Guimli/Pico2-MSX/hardware/Images/Pico2-MSX-front.jpg

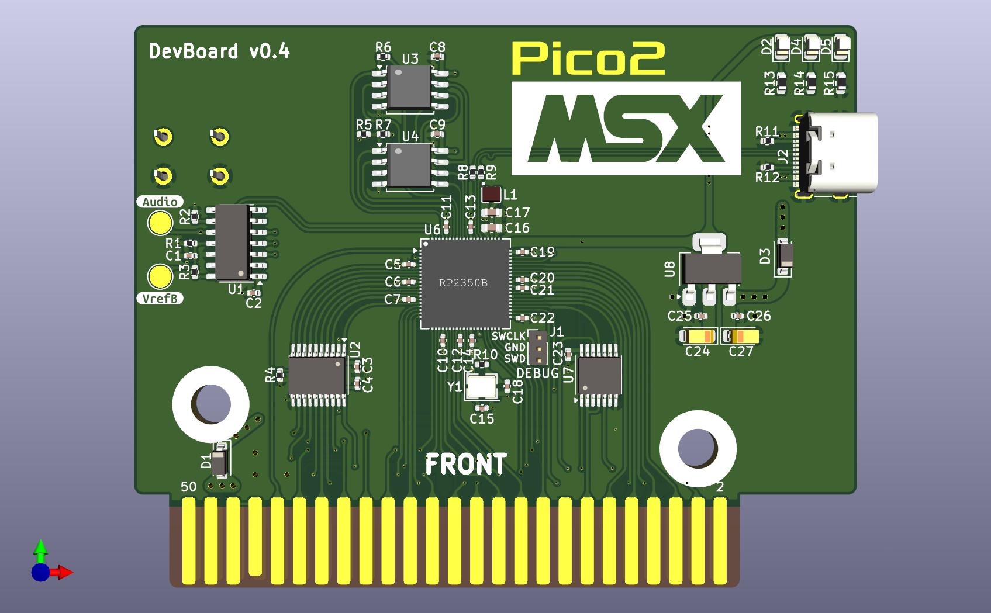
hardware/Images/Pico2-MSX-front.jpg
