Guimli/Pico2-MSX/hardware/Images/Pico2-MSX-back.jpg

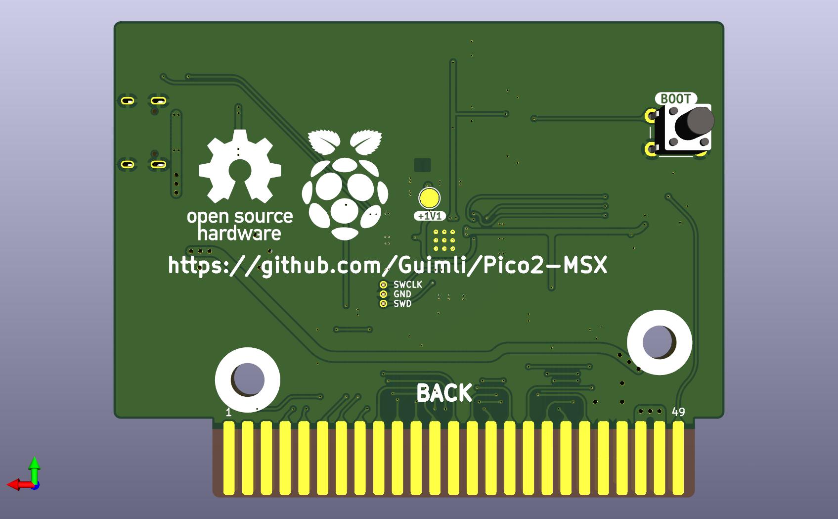
hardware/Images/Pico2-MSX-back.jpg
