Guimli/Pico2-MSX/hardware/3D/L_0806_2016.step

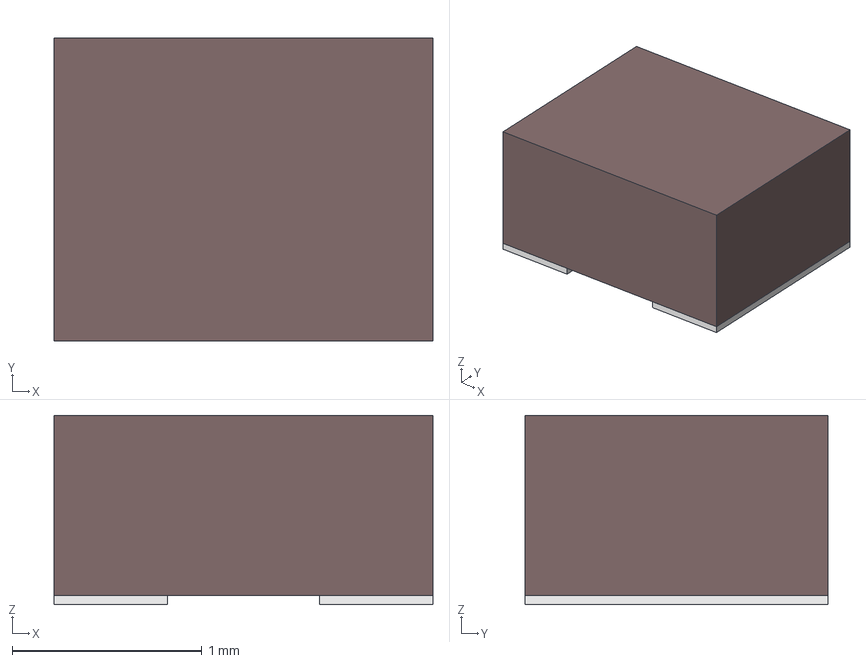
[picture p3: CAD file, 2024-10-25]
hardware/3D/L_0806_2016.step
2.00 x 1.60 x 1.00 mm
Boîte
Boîte001
