Guimli/Pico2-MSX/hardware/3D/SOIC8.STEP

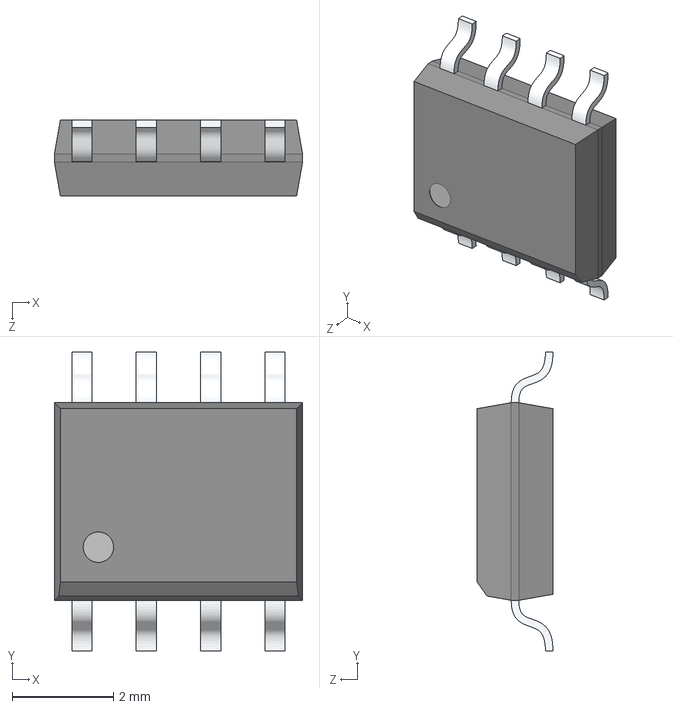
[picture p4: CAD file, 2024-09-10]
hardware/3D/SOIC8.STEP
4.90 x 5.90 x 1.50 mm
