Guimli/Pico2-MSX/hardware/3D/RP2350_QFN80.step

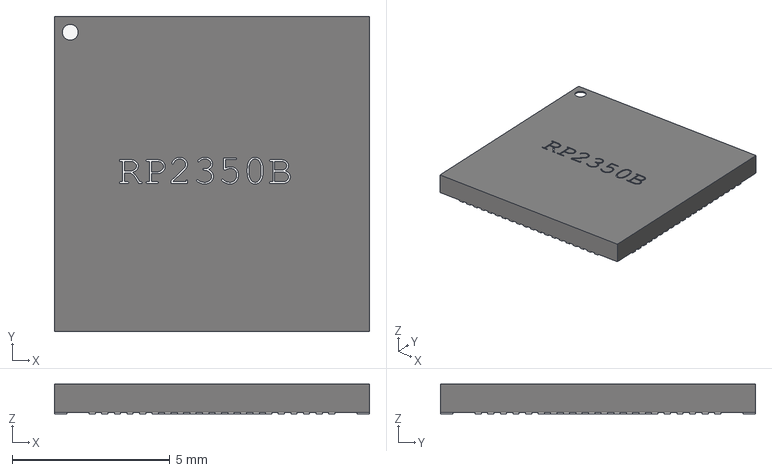
[picture p5: CAD file, 2024-09-10]
hardware/3D/RP2350_QFN80.step
10.0 x 10.0 x 0.95 mm
