Guimli/Pico2-MSX/hardware/Pico2-MSX.pdf

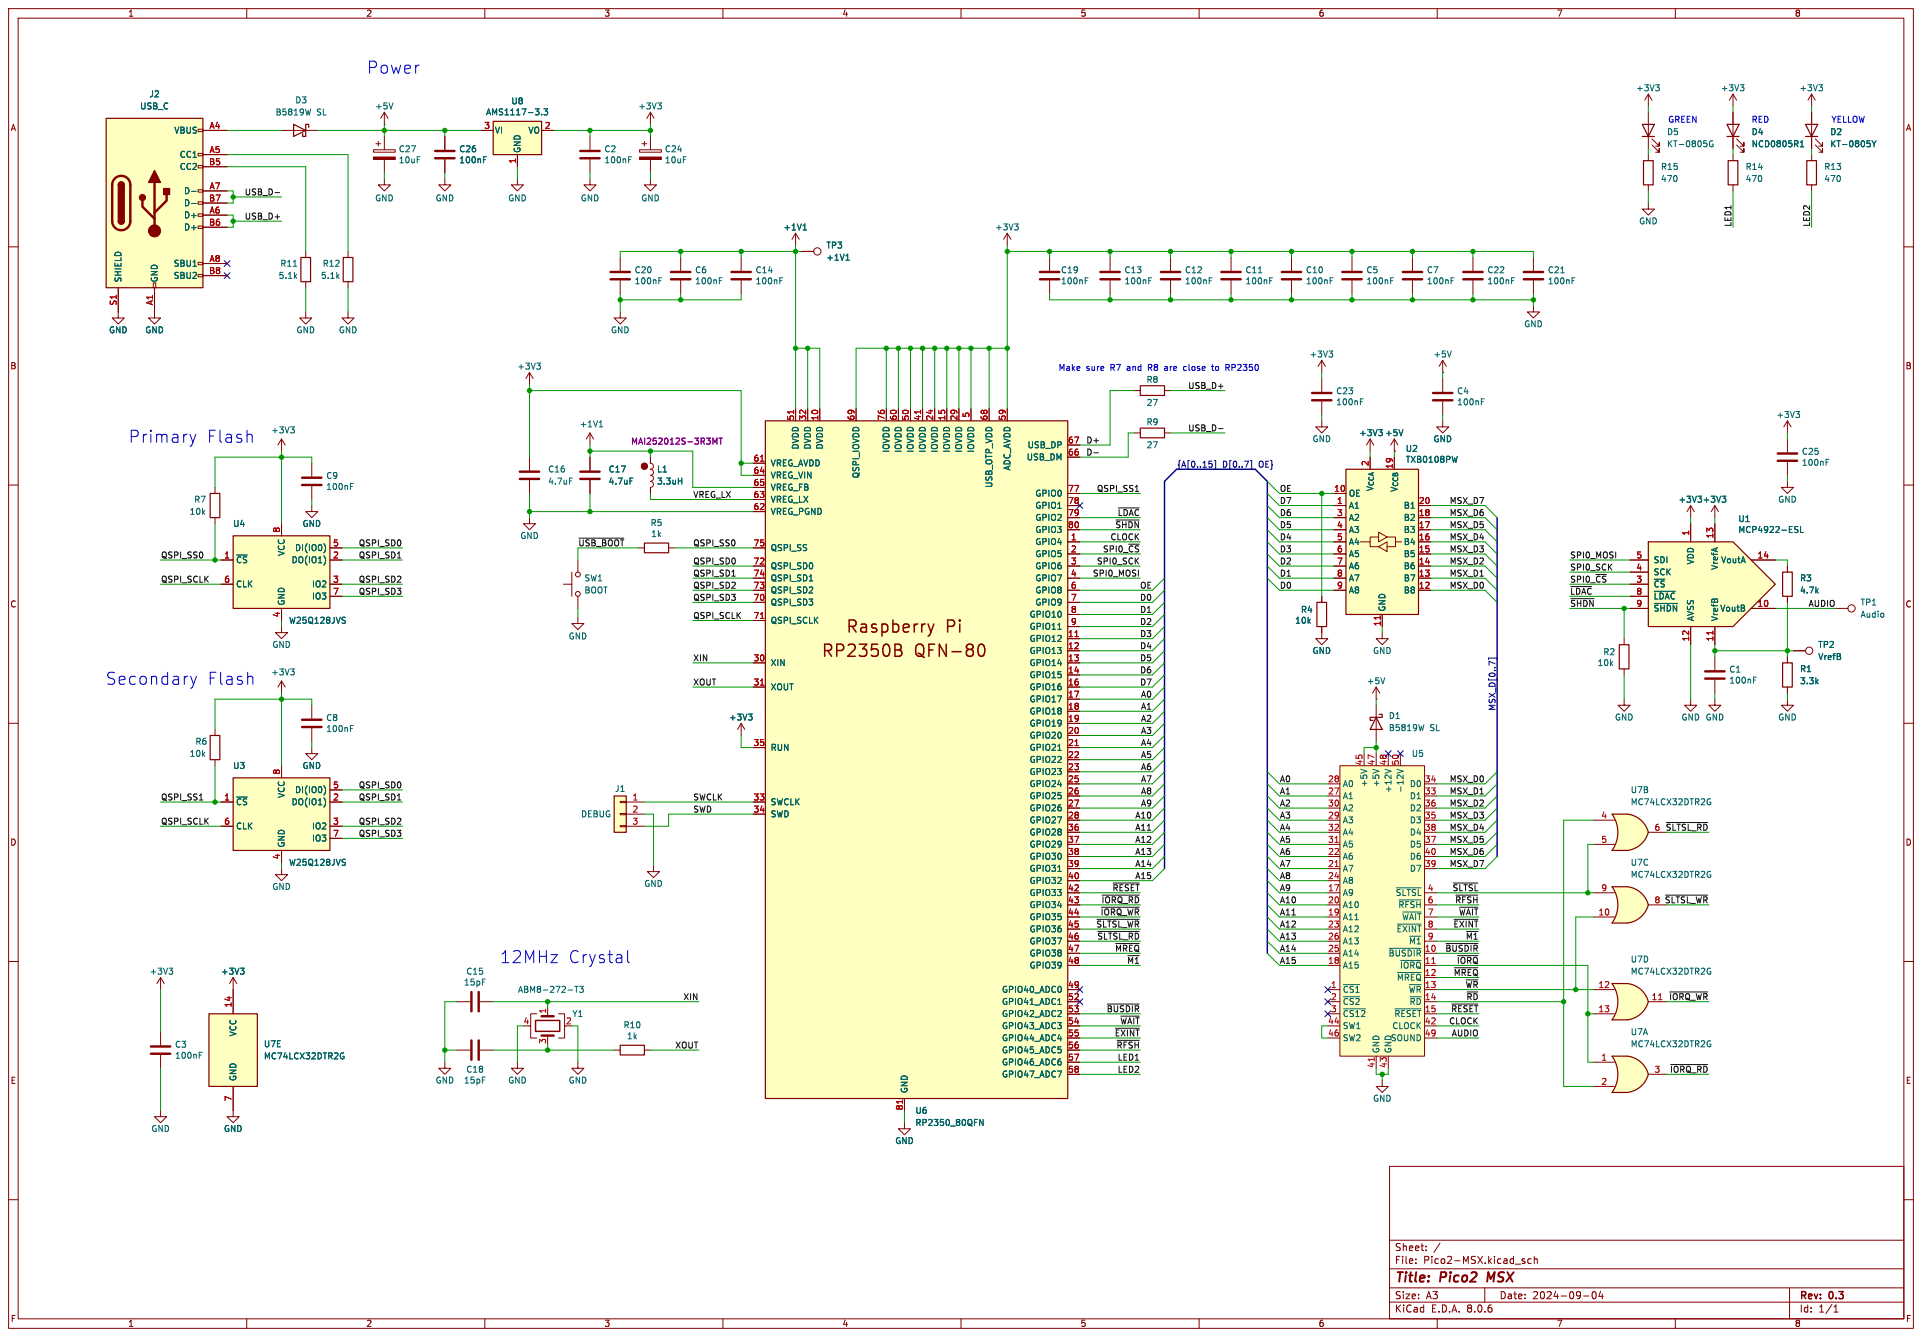
[picture p6: page 1]

1 VO 2 VI 3 U8 AMS1117-3.3 ~{CS} 1 DO(IO1) 2

5 IOVDD 50 DVDD 51 GPIO41_ADC1 52 GPIO42_ADC2 53 GPIO43_ADC3 54 GPIO44_ADC4 55 GPIO45_ADC5 56 GPIO46_ADC6 57 GPIO47_ADC7 58 ADC_AVDD 59 GPIO8 6 IOVDD 60 VREG_AVDD 61 VREG_PGND 62 VREG_LX 63 VREG_VIN 64 VREG_FB 65 USB_DM 66 USB_DP 67 USB_OTP_VDD 68 QSPI_IOVDD 69 GPIO9 7 QSPI_SD3 70 QSPI_SCLK 71 QSPI_SD0 72 QSPI_SD2 73 QSPI_SD1 74 QSPI_SS 75 IOVDD 76 GPIO0 77 GPIO1 78 GPIO2 79 GPIO10 8 GPIO3 80 GND 81 GPIO11 9 +3V3 GND

5 IOVDD 50 DVDD 51 GPIO41_ADC1 52 GPIO42_ADC2 53 GPIO43_ADC3 54 GPIO44_ADC4 55 GPIO45_ADC5 56 GPIO46_ADC6 57 GPIO47_ADC7 58 ADC_AVDD 59 GPIO8 6 IOVDD 60 VREG_AVDD 61 VREG_PGND 62 VREG_LX 63 VREG_VIN 64 VREG_FB 65 USB_DM 66 USB_DP 67 USB_OTP_VDD 68 QSPI_IOVDD 69 GPIO9 7 QSPI_SD3 70 QSPI_SCLK 71 QSPI_SD0 72 QSPI_SD2 73 QSPI_SD1 74 QSPI_SS 75 IOVDD 76 GPIO0 77 GPIO1 78 GPIO2 79 GPIO10 8 GPIO3 80 GND 81 GPIO11 9 U6 RP2350_80QFN
