Guimli/Pico2-MSX/hardware/Pico2-MSX.kicad_pcb

## KiCad design hardware/Pico2-MSX.kicad_pcb (2024-11-30)

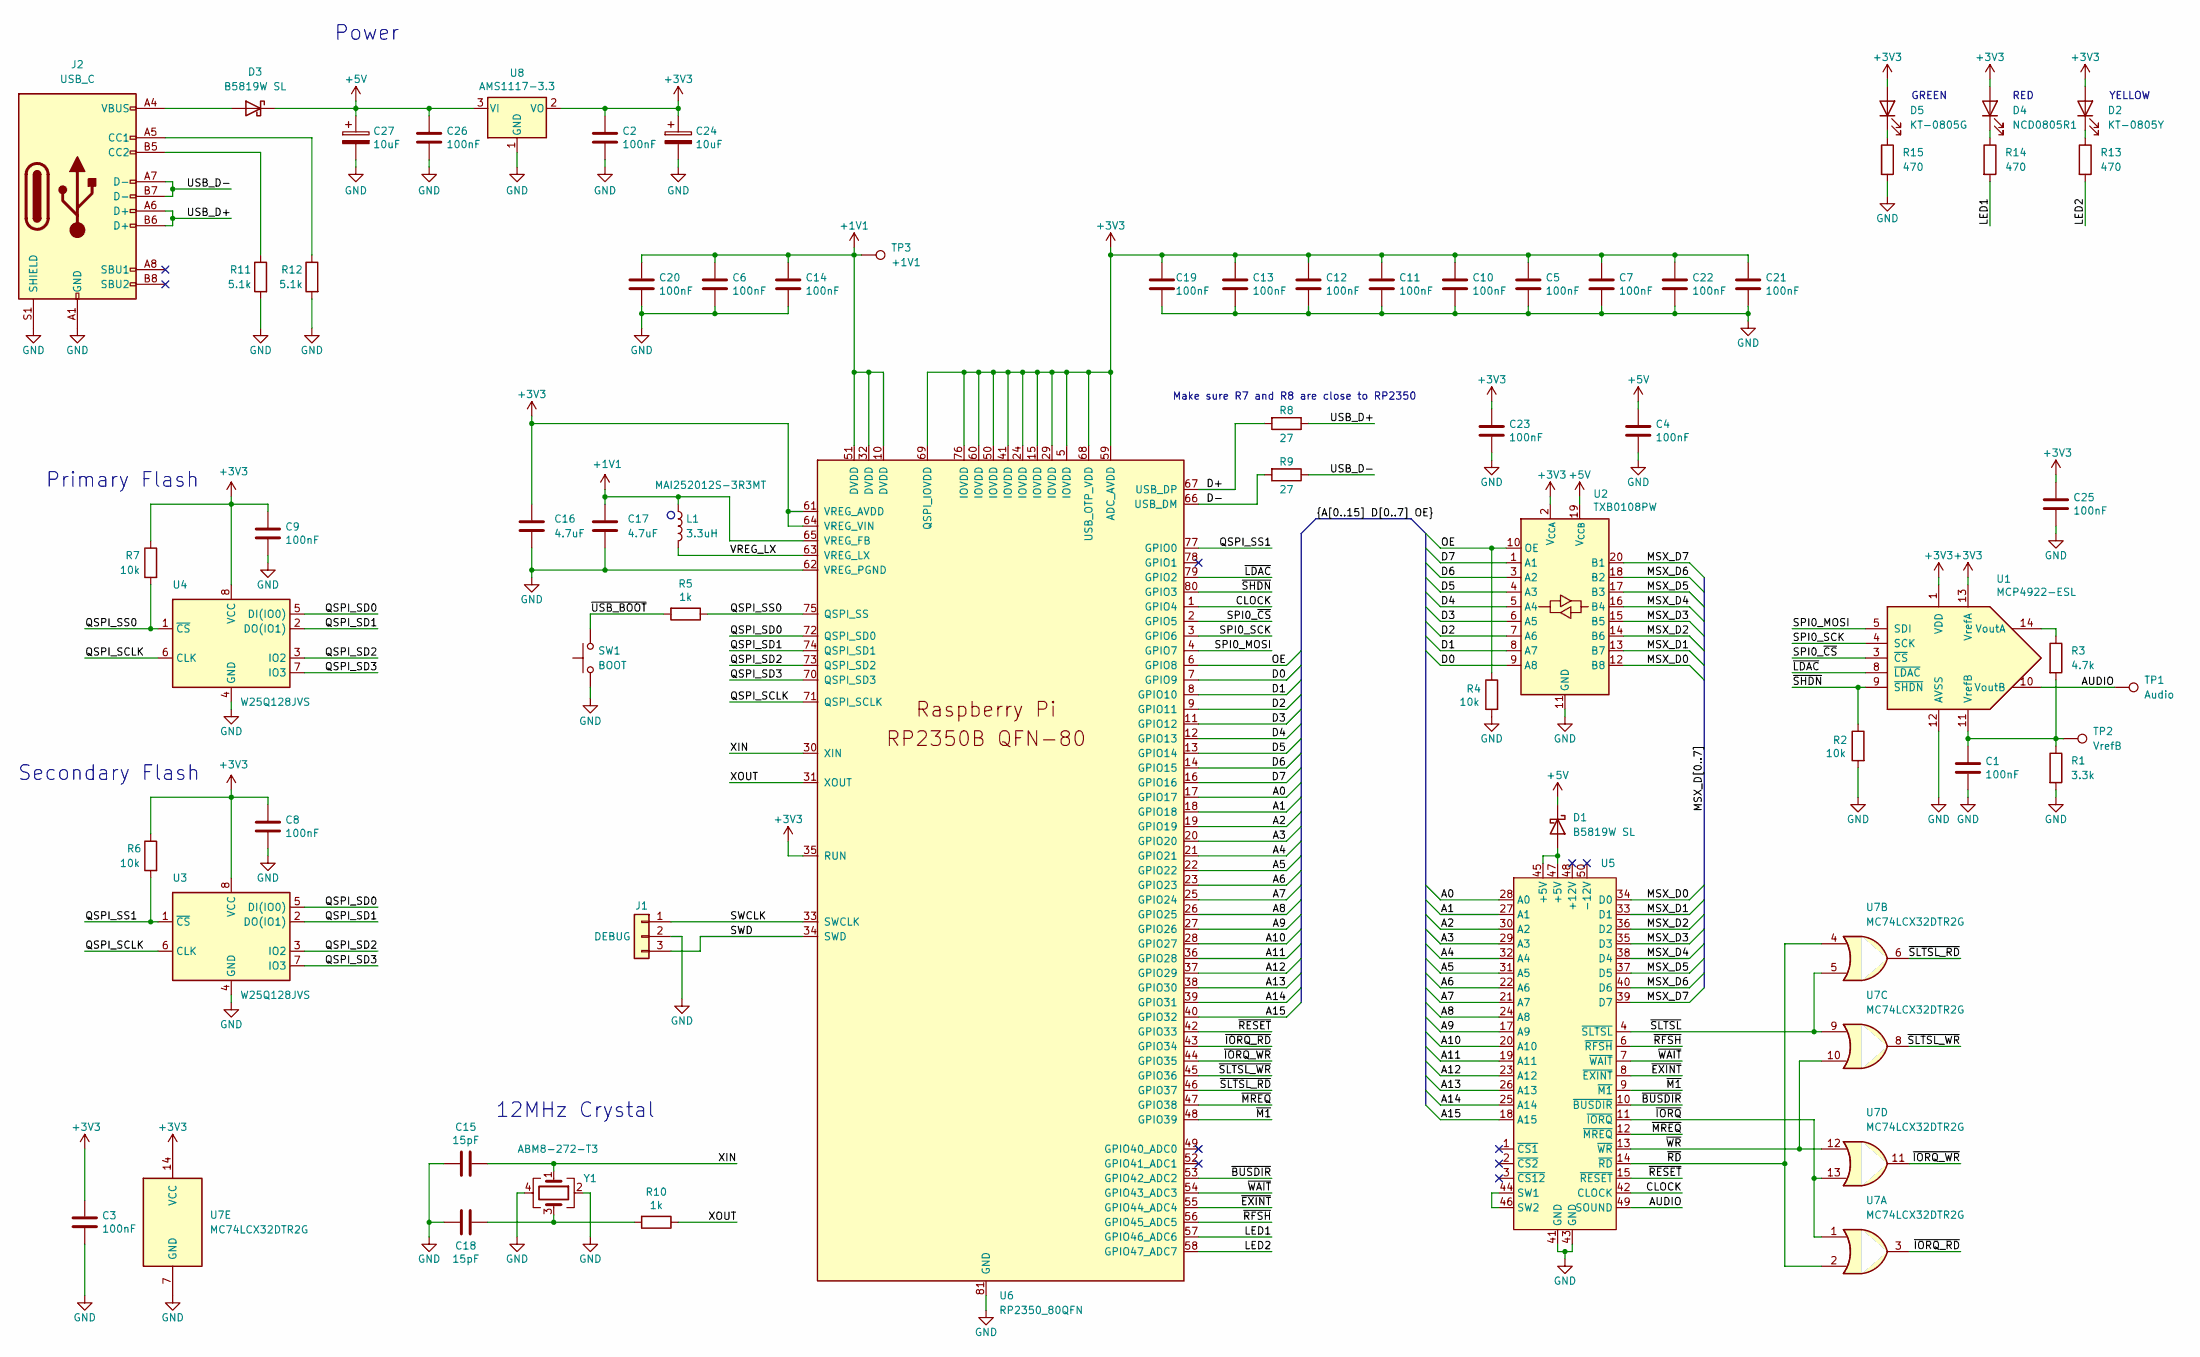
[picture p7: schematic Pico2-MSX.kicad_sch, Pico2 MSX]

Parts:
C1, C2, C3, C4, C8, C9, C23, C25, C26: 100nF; C_0402_1005Metric; LCSC C307331
C5, C6, C7, C10, C11, C12, C13, C14, C19, C20, C21, C22: 100nF; C_0402_1005Metric_thin; LCSC C307331
C15, C18: 15pF; C_0402_1005Metric; LCSC C1548
C16, C17: 4.7uF; C_0603_1608Metric_small; LCSC C19666
C24, C27: 10uF; CP_EIA-3216-18_Kemet-A; LCSC C7171
D1, D3: B5819W SL; D_SOD-123; LCSC C8598
D2: KT-0805Y; LED_0805_2012Metric; LCSC C2296
D4: NCD0805R1; LED_0805_2012Metric; LCSC C84256
D5: KT-0805G; LED_0805_2012Metric; LCSC C2297
J1: DEBUG; PinHeader_1x03_P1.27mm_Vertical; LCSC C24980
J2: USB_C; USB_C_Receptacle_G-Switch_GT-USB-7010ASV; LCSC C2988369
L1: 3.3uH; L_pol_2016; LCSC C520252
R1: 3.3k; R_0402_1005Metric; LCSC C25890
R2, R4, R6, R7: 10k; R_0402_1005Metric; LCSC C25744
R3: 4.7k; R_0402_1005Metric; LCSC C25900
R5, R10: 1k; R_0402_1005Metric; LCSC C11702
R8, R9: 27; R_0402_1005Metric; LCSC C25100
R11, R12: 5.1k; R_0402_1005Metric; LCSC C25905
R13, R14, R15: 470; R_0603_1608Metric; LCSC C23179
SW1: BOOT; SW_PUSH_6mm_H7.3mm
TP1: Audio; TestPoint_Pad_D2.5mm
TP2: VrefB; TestPoint_Pad_D2.5mm
TP3: +1V1; TestPoint_Pad_D2.5mm
U1: MCP4922-ESL; SOIC-14_3.9x8.7mm_P1.27mm; LCSC C39851
U2: TXB0108PW; TSSOP-20_4.4x6.5mm_P0.65mm; LCSC C53406
U3, U4: W25Q128JVS; SOIC-8_5.23x5.23mm_P1.27mm; LCSC C97521
U5: MSX_Cartridge
U6: RP2350_80QFN; RP2350-QFN-80-1EP_10x10_P0.4mm_EP3.4x3.4mm_ThermalVias; LCSC C9900138392
U7: MC74LCX32DTR2G; TSSOP-14_4.4x5mm_P0.65mm; LCSC C904104
U8: AMS1117-3.3; SOT-223-3_TabPin2; LCSC C6186
Y1: ABM8-272-T3; Crystal_SMD_3225-4Pin_3.2x2.5mm; LCSC C9002

Connections:
+1V1: C6.1, C14.1, C17.1, C20.1, L1.1, TP3.1, U6.10 (DVDD), U6.32 (DVDD), U6.51 (DVDD), U6.65 (VREG_FB)
+3V3: C2.1, C3.1, C5.1, C7.1, C8.1, C9.1, C10.1, C11.1, C12.1, C13.1, C16.1, C19.1, C21.1, C22.1, C23.1, C24.1, C25.1, D2.2 (A), D4.2 (A), D5.2 (A), R6.1, R7.1, U1.1 (VDD), U1.13 (VrefA), U2.2 (V_{CCA}), U3.8 (VCC), U4.8 (VCC), U6.5 (IOVDD), U6.15 (IOVDD), U6.24 (IOVDD), U6.29 (IOVDD), U6.35 (RUN), U6.41 (IOVDD), U6.50 (IOVDD), U6.59 (ADC_AVDD), U6.60 (IOVDD), U6.61 (VREG_AVDD), U6.64 (VREG_VIN), U6.68 (USB_OTP_VDD), U6.69 (QSPI_IOVDD), U6.76 (IOVDD), U7.14 (VCC), U8.2 (VO)
+5V: C4.1, C26.1, C27.1, D1.1 (K), D3.1 (K), U2.19 (V_{CCB}), U8.3 (VI)
/A0: U5.28 (A0), U6.17 (GPIO17)
/A1: U5.27 (A1), U6.18 (GPIO18)
/A2: U5.30 (A2), U6.19 (GPIO19)
/A3: U5.29 (A3), U6.20 (GPIO20)
/A4: U5.32 (A4), U6.21 (GPIO21)
/A5: U5.31 (A5), U6.22 (GPIO22)
/A6: U5.22 (A6), U6.23 (GPIO23)
/A7: U5.21 (A7), U6.25 (GPIO24)
/A8: U5.24 (A8), U6.26 (GPIO25)
/A9: U5.17 (A9), U6.27 (GPIO26)
/A10: U5.20 (A10), U6.28 (GPIO27)
/A11: U5.19 (A11), U6.36 (GPIO28)
/A12: U5.23 (A12), U6.37 (GPIO29)
/A13: U5.26 (A13), U6.38 (GPIO30)
/A14: U5.25 (A14), U6.39 (GPIO31)
/A15: U5.18 (A15), U6.40 (GPIO32)
/AUDIO: TP1.1, U1.10 (VoutB), U5.49 (SOUND)
/CLOCK: U5.42 (CLOCK), U6.1 (GPIO4)
/D0: U2.9 (A8), U6.7 (GPIO9)
/D1: U2.8 (A7), U6.8 (GPIO10)
/D2: U2.7 (A6), U6.9 (GPIO11)
/D3: U2.6 (A5), U6.11 (GPIO12)
/D4: U2.5 (A4), U6.12 (GPIO13)
/D5: U2.4 (A3), U6.13 (GPIO14)
/D6: U2.3 (A2), U6.14 (GPIO15)
/D7: U2.1 (A1), U6.16 (GPIO16)
/D+: R8.2, U6.67 (USB_DP)
/D-: R9.2, U6.66 (USB_DM)
/LED1: R14.2, U6.57 (GPIO46_ADC6)
/LED2: R13.2, U6.58 (GPIO47_ADC7)
/MSX_D0: U2.12 (B8), U5.34 (D0)
/MSX_D1: U2.13 (B7), U5.33 (D1)
/MSX_D2: U2.14 (B6), U5.36 (D2)
/MSX_D3: U2.15 (B5), U5.35 (D3)
/MSX_D4: U2.16 (B4), U5.38 (D4)
/MSX_D5: U2.17 (B3), U5.37 (D5)
/MSX_D6: U2.18 (B2), U5.40 (D6)
/MSX_D7: U2.20 (B1), U5.39 (D7)
/OE: R4.1, U2.10 (OE), U6.6 (GPIO8)
/QSPI_SCLK: U3.6 (CLK), U4.6 (CLK), U6.71 (QSPI_SCLK)
/QSPI_SD0: U3.5 (DI(IO0)), U4.5 (DI(IO0)), U6.72 (QSPI_SD0)
/QSPI_SD1: U3.2 (DO(IO1)), U4.2 (DO(IO1)), U6.74 (QSPI_SD1)
/QSPI_SD2: U3.3 (IO2), U4.3 (IO2), U6.73 (QSPI_SD2)
/QSPI_SD3: U3.7 (IO3), U4.7 (IO3), U6.70 (QSPI_SD3)
/QSPI_SS0: R5.1, R7.2, U4.1 (~CS), U6.75 (QSPI_SS)
/QSPI_SS1: R6.2, U3.1 (~CS), U6.77 (GPIO0)
/SPI0_MOSI: U1.5 (SDI), U6.4 (GPIO7)
/SPI0_SCK: U1.4 (SCK), U6.3 (GPIO6)
/SPI0_~CS: U1.3 (~CS), U6.2 (GPIO5)
/SWCLK: J1.1, U6.33 (SWCLK)
/SWD: J1.3, U6.34 (SWD)
/USB_D+: J2.A6 (D+), J2.B6 (D+), R8.1
/USB_D-: J2.A7 (D-), J2.B7 (D-), R9.1
/VREG_LX: L1.2, U6.63 (VREG_LX)
/XIN: C15.1, U6.30 (XIN), Y1.1
/XOUT: R10.1, U6.31 (XOUT)
/~BUSDIR: U5.10 (~BUSDIR), U6.53 (GPIO42_ADC2)
/~EXINT: U5.8 (~EXINT), U6.55 (GPIO44_ADC4)
/~IORQ_RD: U6.43 (GPIO34), U7.3
/~IORQ_WR: U6.44 (GPIO35), U7.11
/~IORQ: U5.11 (~IORQ), U7.1, U7.13
/~LDAC: U1.8 (~LDAC), U6.79 (GPIO2)
/~M1: U5.9 (~M1), U6.48 (GPIO39)
/~MREQ: U5.12 (~MREQ), U6.47 (GPIO38)
/~RD: U5.14 (~RD), U7.2, U7.4
/~RESET: U5.15 (~RESET), U6.42 (GPIO33)
/~RFSH: U5.6 (~RFSH), U6.56 (GPIO45_ADC5)
/~SHDN: R2.1, U1.9 (~SHDN), U6.80 (GPIO3)
/~SLTSL_RD: U6.46 (GPIO37), U7.6
/~SLTSL_WR: U6.45 (GPIO36), U7.8
/~SLTSL: U5.4 (~SLTSL), U7.5, U7.9
/~USB_BOOT: R5.2, SW1.2
/~WAIT: U5.7 (~WAIT), U6.54 (GPIO43_ADC3)
/~WR: U5.13 (~WR), U7.10, U7.12
GND: C1.2, C2.2, C3.2, C4.2, C5.2, C6.2, C7.2, C8.2, C9.2, C10.2, C11.2, C12.2, C13.2, C14.2, C15.2, C16.2, C17.2, C18.2, C19.2, C20.2, C21.2, C22.2, C23.2, C24.2, C25.2, C26.2, C27.2, J1.2, J2.A1 (GND), J2.A12 (GND), J2.B1 (GND), J2.B12 (GND), J2.S1 (SHIELD), R1.2, R2.2, R4.2, R11.2, R12.2, R15.2, SW1.1, U1.12 (AVSS), U2.11 (GND), U3.4 (GND), U4.4 (GND), U5.41 (GND), U5.43 (GND), U6.62 (VREG_PGND), U6.81 (GND), U7.7 (GND), U8.1 (GND), Y1.2, Y1.4
unnamed: C18.1, R10.2, Y1.3
unnamed: D1.2 (A), U5.45 (+5V), U5.47 (+5V)
unnamed: D2.1 (K), R13.1
unnamed: D3.2 (A), J2.A4 (VBUS), J2.A9 (VBUS), J2.B4 (VBUS), J2.B9 (VBUS)
unnamed: D4.1 (K), R14.1
unnamed: D5.1 (K), R15.1
unnamed: J2.A5 (CC1), R12.1
unnamed: J2.B5 (CC2), R11.1
unnamed: R3.1, U1.14 (VoutA)
unnamed: C1.1, R1.1, R3.2, TP2.1, U1.11 (VrefB)
unnamed: U5.44 (SW1), U5.46 (SW2)

Notes on the sheet:
12MHz Crystal
RED
Primary Flash
YELLOW
Make sure R7 and R8 are close to RP2350
Secondary Flash
Power
GREEN

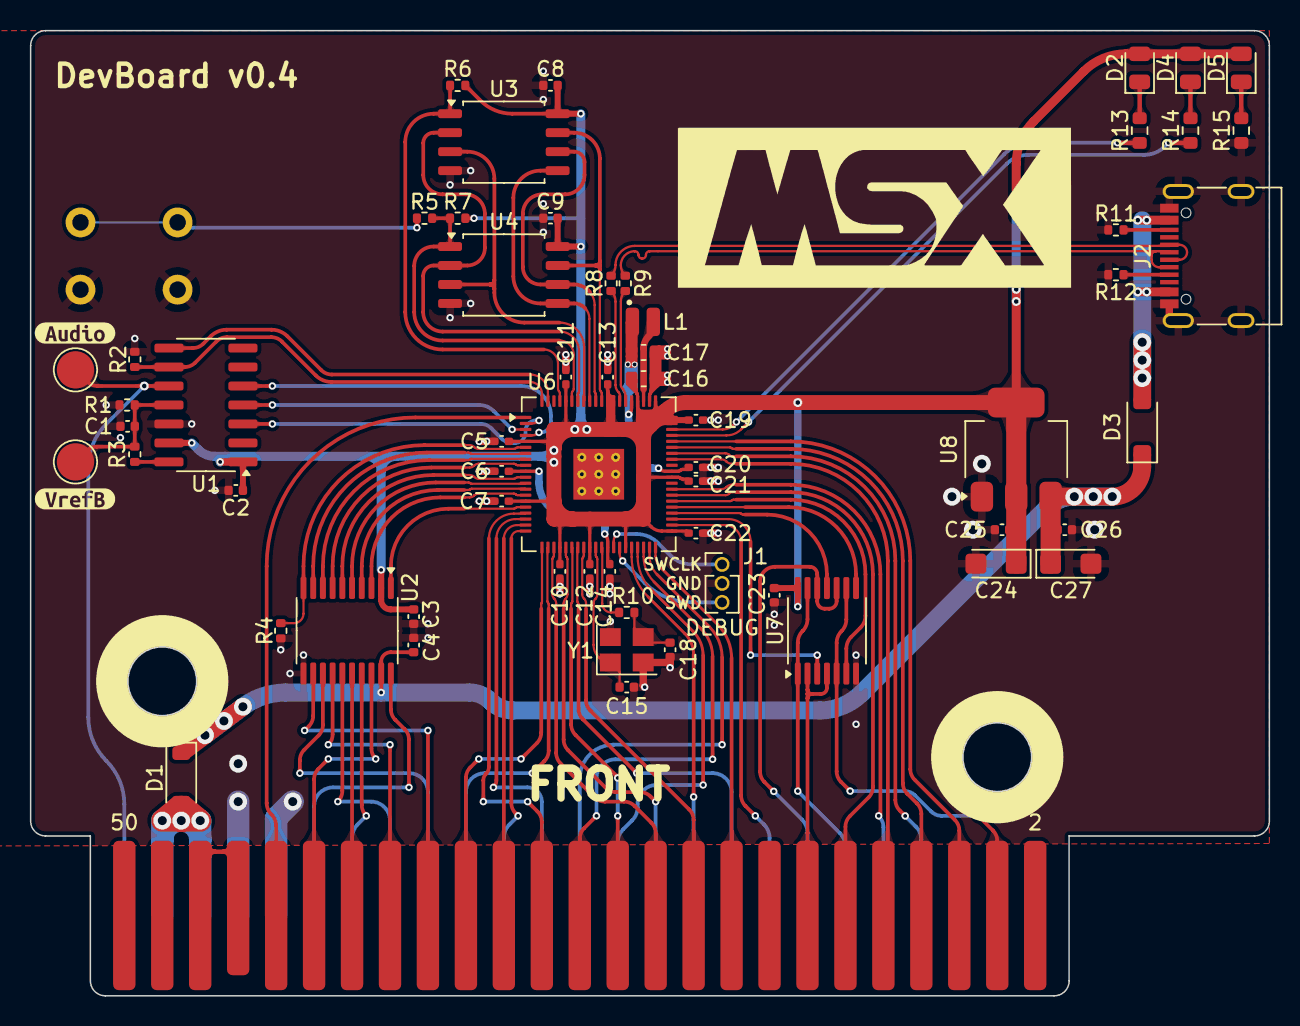
[picture p8: board Pico2-MSX.kicad_pcb from above]

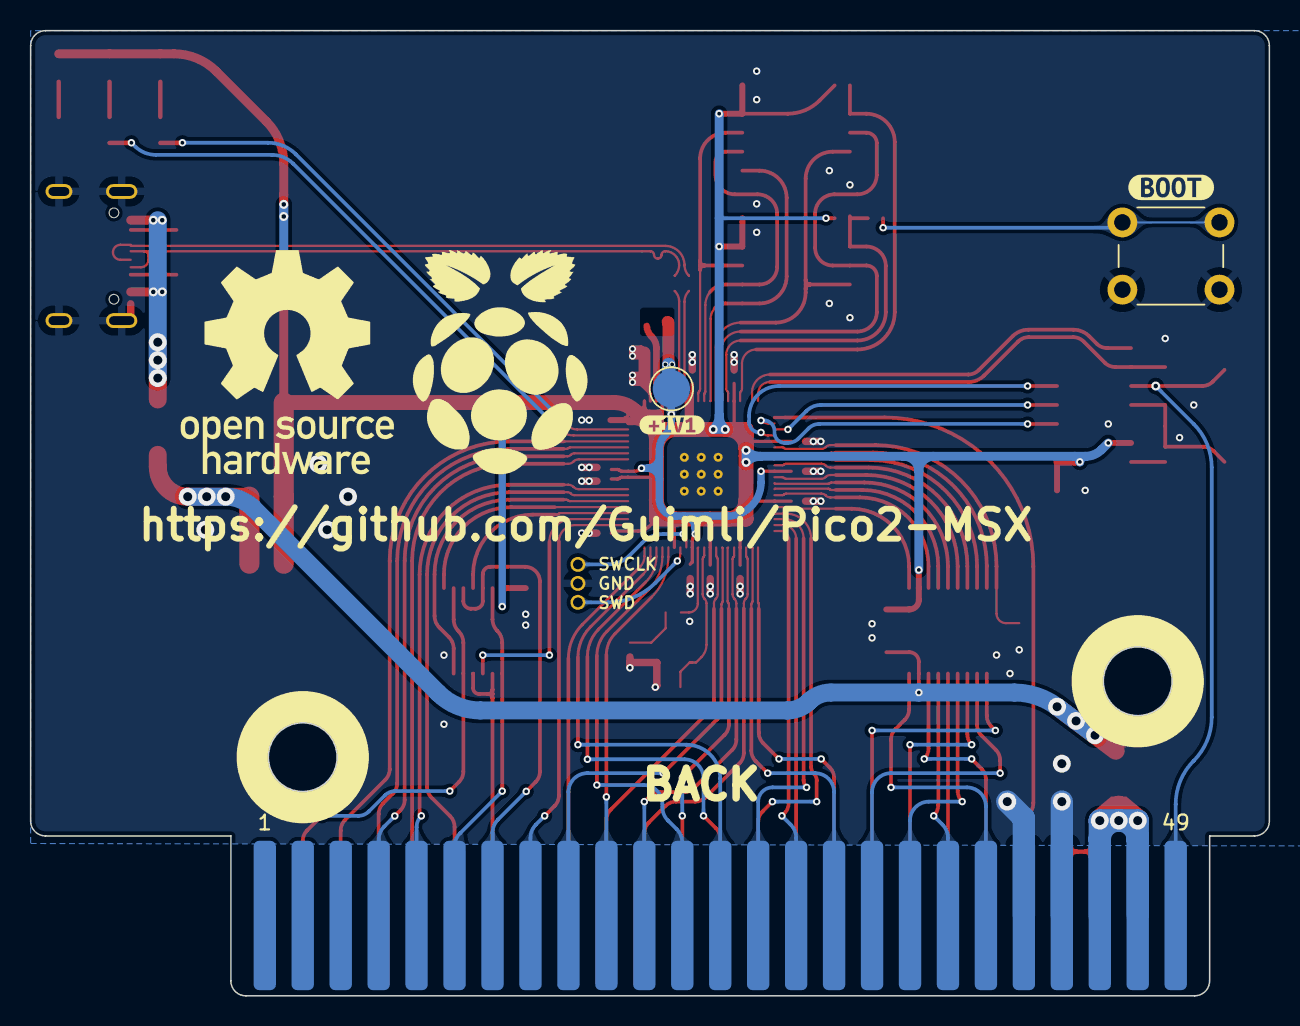
[picture p9: board Pico2-MSX.kicad_pcb from below]

Board: 4 copper layers, 82.9 x 64.6 mm, 67 parts (4 on the bottom side), 89 nets.

Other parts of the board:
kibuzzard-671CD39D: G***; kibuzzard-671CD39D
kibuzzard-671CD351: G***; kibuzzard-671CD351
kibuzzard-671CD378: G***; kibuzzard-671CD378
kibuzzard-671CD496: G***; kibuzzard-671CD496
