Guimli/Pico2-MSX/(commit log)

2024-10-25 Improving the 1v1 circuit
    [BOM-Pico2-MSX.csv, L_0806_2016.step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]
2024-10-28 Some optimizations
    [Pico2-MSX-B_Cu.gbr, Pico2-MSX-B_Mask.gbr, Pico2-MSX-B_Paste.gbr, Pico2-MSX-B_Silkscreen.gbr, Pico2-MSX-Edge_Cuts.gbr, Pico2-MSX-F_Cu.gbr, Pico2-MSX-F_Mask.gbr, Pico2-MSX-F_Paste.gbr]
2024-11-14 Delete via for flash memory
    And other small modifications (reference at JLCPCB)
    [BOM-Pico2-MSX.csv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]
2024-11-30 Cost reduction and correction of fixing hole placement
    - The via are now at a minimum hole size of 0.25.
    - The 0201 capacitors have been replaced by 0402s.
    - The fixing holes have been moved to a position closer to the standard.
    - The tracks have been widened outside the RP2350 area.
    [BOM-Pico2-MSX.csv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]
